ArtaChris/openlst-hw/openlst-hw.kicad_sch

## KiCad design openlst-hw.kicad_sch (2022-05-09)

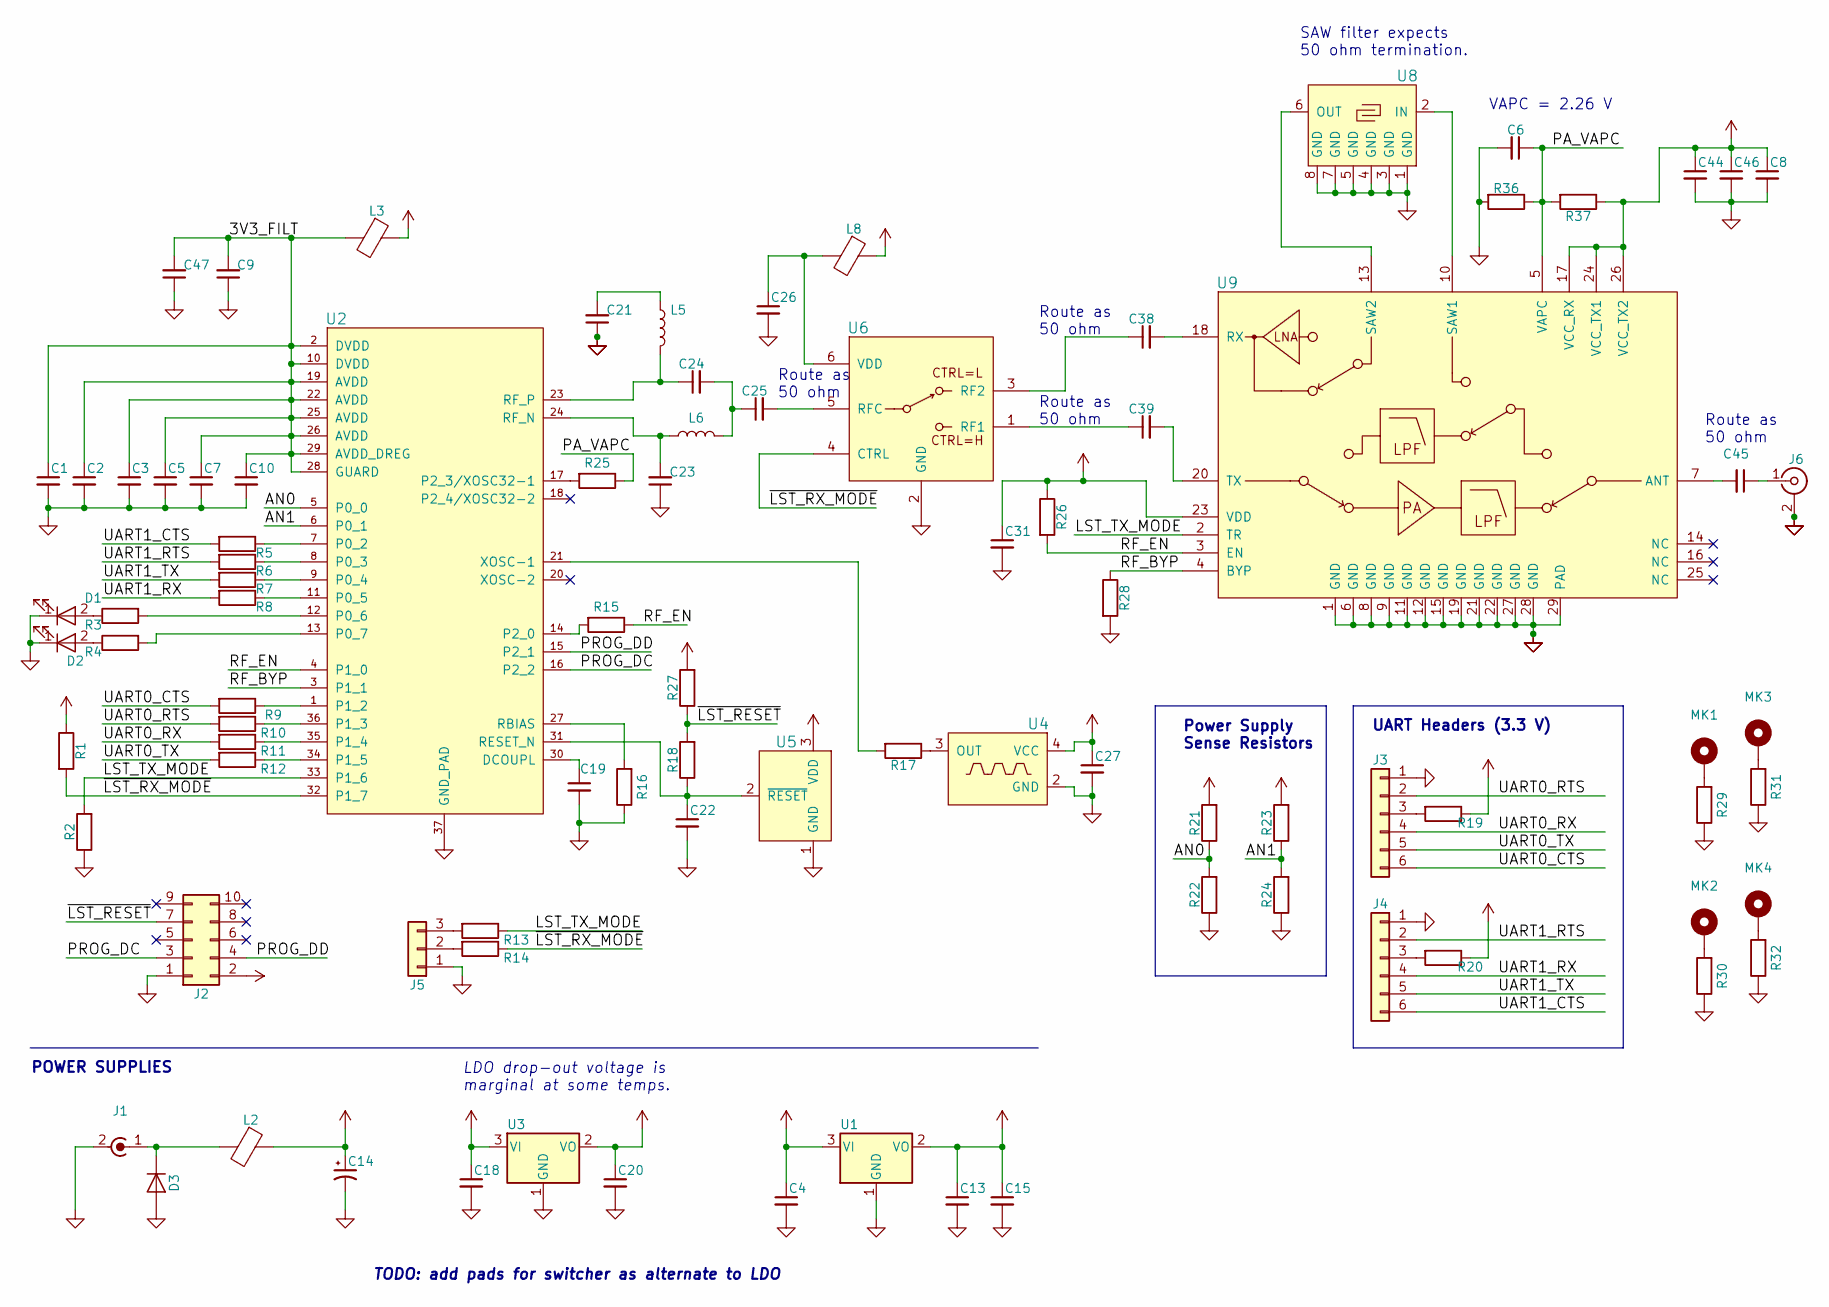
[picture p1: schematic openlst-hw.kicad_sch]

Parts:
C1, C3, C5, C6, C8, C10, C15, C26, C27, C31: ManufPN 0603YC104K4T4A
C2, C7, C21, C25, C38, C39, C45: ManufPN C0402C221J2GACAUTO
C4, C13, C18, C20: ManufPN GRT188C81A106ME13D
C9, C44, C46, C47: ManufPN CL10B105MO8NNWC
C14: ManufPN TPSB107M010R0400
C19, C22: ManufPN GCM188R71E102KA37D
C23, C24: ManufPN GJM1555C1H3R9CB01D
D1: ManufPN 150060VS75000
D2: ManufPN 150060SS75000
D3: ManufPN STPS340U
J1, J5: (no value)
J2: ManufPN FTSH-105-01-L-DV-K-P
J3, J4: ManufPN 61300611121
J6: ManufPN 732511150
L2: ManufPN MI1206L501R-10
L3, L8: ManufPN 74279266
L5, L6: ManufPN LQW15AN27NJ00D
MK1, MK2, MK3, MK4: (no value)
R1, R2, R3, R4, R18, R26, R28: ManufPN RC0603JR-071KL
R5, R6, R7, R8, R9, R10, R11, R12, R13, R14, R17: ManufPN AC0603FR-07100RL
R15, R19, R20, R25, R29, R30, R31, R32: (no value)
R16: ManufPN RMCF0603FT56K0
R21, R23, R27: ManufPN AC0603FR-0733KL
R22, R24: ManufPN RC0603JR-0710KL
R36: ManufPN RMCF0603FT5K60
R37: ManufPN RMCF0603FT3K30
U1: ManufPN LM1117IMP-3.3/NOPB
U2: ManufPN CC1110F32RHHR
U3: ManufPN LT1086CM-3.6#PBF
U4: ManufPN FT5HNBPK27.0-T1
U5: ManufPN TLV803SDBZR
U6: ManufPN 4259-63
U8: ManufPN STA1120A
U9: ManufPN RFFM6403SB

Connections:
3V3_FILT: C1.1, C2.1, C3.1, C5.1, C7.1, C9.2, C10.1, C47.2, L3.2, U2.2 (DVDD), U2.10 (DVDD), U2.19 (AVDD), U2.22 (AVDD), U2.25 (AVDD), U2.26 (AVDD), U2.28 (GUARD), U2.29 (AVDD_DREG)
AN0: R21.1, R22.2, U2.5 (P0_0)
AN1: R23.1, R24.2, U2.6 (P0_1)
LST_TX_MODE: R2.2, R13.1, U2.33 (P1_6), U9.2 (TR)
unnamed: C1.2, C2.2, C3.2, C4.1, C4.2, C5.2, C6.2, C7.2, C8.1, C8.2, C9.1, C10.2, C13.1, C13.2, C14.1, C14.2, C15.1, C15.2, C18.1, C18.2, C19.2, C20.1, C20.2, C21.1, C22.2, C23.1, C26.2, C27.1, C27.2, C31.1, C31.2, C44.1, C44.2, C46.1, C46.2, C47.1, D1.1 (K), D2.1 (K), D3.2 (A), J1.2 (Ext), J2.1, J2.2, J3.1, J4.1, J5.1, J6.2 (Ext), L2.1, L3.1, L8.1, R1.1, R2.1, R16.1, R19.1, R20.1, R21.2, R22.1, R23.2, R24.1, R26.1, R27.2, R28.2, R29.1, R30.1, R31.1, R32.1, R36.2, R37.1, U1.1 (GND), U1.2 (VO), U1.3 (VI), U2.37 (GND_PAD), U3.1 (GND), U3.2 (VO), U3.3 (VI), U4.2 (GND), U4.4 (VCC), U5.1 (GND), U5.3 (VDD), U6.2 (GND), U8.1 (GND), U8.3 (GND), U8.4 (GND), U8.5 (GND), U8.7 (GND), U8.8 (GND), U9.1 (GND), U9.6 (GND), U9.8 (GND), U9.9 (GND), U9.11 (GND), U9.12 (GND), U9.15 (GND), U9.17 (VCC_RX), U9.19 (GND), U9.21 (GND), U9.22 (GND), U9.23 (VDD), U9.24 (VCC_TX1), U9.26 (VCC_TX2), U9.27 (GND), U9.28 (GND), U9.29 (PAD)
unnamed: C19.1, U2.30 (DCOUPL)
unnamed: C21.2, L5.1
unnamed: C22.1, R18.1, U2.31 (RESET_N), U5.2 (~RESET)
unnamed: C23.2, L6.1, U2.24 (RF_N)
unnamed: C24.1, L5.2, U2.23 (RF_P)
unnamed: C24.2, C25.1, L6.2
unnamed: C25.2, U6.5 (RFC)
unnamed: C26.1, L8.2, U6.6 (VDD)
unnamed: C38.1, U6.3 (RF2)
unnamed: C38.2, U9.18 (RX)
unnamed: C39.1, U6.1 (RF1)
unnamed: C39.2, U9.20 (TX)
unnamed: C45.1, J6.1 (In)
unnamed: C45.2, U9.7 (ANT)
unnamed: D1.2 (A), R3.1
unnamed: D2.2 (A), R4.1
unnamed: D3.1 (K), J1.1 (In), L2.2
unnamed: J3.3, R19.2
unnamed: J4.3, R20.2
unnamed: J5.2, R14.2
unnamed: J5.3, R13.2
unnamed: MK1.1, R29.2
unnamed: MK2.1, R30.2
unnamed: MK3.1, R31.2
unnamed: MK4.1, R32.2
unnamed: R3.2, U2.12 (P0_6)
unnamed: R4.2, U2.13 (P0_7)
unnamed: R5.1, U2.7 (P0_2)
unnamed: R6.1, U2.8 (P0_3)
unnamed: R7.1, U2.9 (P0_4)
unnamed: R8.1, U2.11 (P0_5)
unnamed: R9.1, U2.1 (P1_2)
unnamed: R10.1, U2.36 (P1_3)
unnamed: R11.1, U2.35 (P1_4)
unnamed: R12.1, U2.34 (P1_5)
unnamed: R15.2, U2.14 (P2_0)
unnamed: R16.2, U2.27 (RBIAS)
unnamed: R17.1, U4.3 (OUT)
unnamed: R17.2, U2.21 (XOSC-1)
unnamed: R25.2, U2.17 (P2_3/XOSC32-1)
unnamed: U8.2 (IN), U9.10 (SAW1)
unnamed: U8.6 (OUT), U9.13 (SAW2)
PA_VAPC: C6.1, R25.1, R36.1, R37.2, U9.5 (VAPC)
PROG_DC: J2.3, U2.16 (P2_2)
PROG_DD: J2.4, U2.15 (P2_1)
RF_BYP: R28.1, U2.3 (P1_1), U9.4 (BYP)
RF_EN: R15.1, R26.2, U2.4 (P1_0), U9.3 (EN)
UART0_CTS: J3.6, R9.2
UART0_RTS: J3.2, R10.2
UART0_RX: J3.4, R11.2
UART0_TX: J3.5, R12.2
UART1_CTS: J4.6, R5.2
UART1_RTS: J4.2, R6.2
UART1_RX: J4.4, R8.2
UART1_TX: J4.5, R7.2
~LST_RESET: J2.7, R18.2, R27.1
~LST_RX_MODE: R1.2, R14.1, U2.32 (P1_7), U6.4 (CTRL)

Notes on the sheet:
SAW filter expects 50 ohm termination.
Route as 50 ohm
TODO: add pads for switcher as alternate to LDO
POWER SUPPLIES
UART Headers (3.3 V)
Power Supply Sense Resistors
LDO drop-out voltage is marginal at some temps.
VAPC = 2.26 V
