ArtaChris/openlst-hw/rescue-backup/openlst-hw-2022-05-08-21-41-04.sch

## KiCad design rescue-backup/openlst-hw-2022-05-08-21-41-04.sch (2022-05-09)

Schematic: openlst-hw-2022-05-08-21-41-04.sch

Parts:
C1, C3, C5, C6, C8, C10, C15, C26, C27, C31: 0.1u; C_0603_1608Metric; ManufPN 0603YC104K4T4A
C2, C7, C21, C25, C38, C39, C45: 220p; C_0402_1005Metric; ManufPN C0402C221J2GACAUTO
C4, C13, C18, C20: 10u; C_0603_1608Metric; ManufPN GRT188C81A106ME13D
C9, C44, C46, C47: 1u; C_0603_1608Metric; ManufPN CL10B105MO8NNWC
C14: 100u; CP_EIA-3528-15_AVX-H; ManufPN TPSB107M010R0400
C19, C22: 1n; C_0603_1608Metric; ManufPN GCM188R71E102KA37D
C23, C24: 3.9p; C_0402_1005Metric; ManufPN GJM1555C1H3R9CB01D
D1: LED; LED_0603_1608Metric; ManufPN 150060VS75000
D2: LED; LED_0603_1608Metric; ManufPN 150060SS75000
D3: STPS340U; D_SMB; ManufPN STPS340U
J1: 5VDC; PinHeader_1x02_P2.54mm_Vertical
J2: CC Prog/Debug; PinHeader_2x05_P1.27mm_Vertical_SMD; ManufPN FTSH-105-01-L-DV-K-P
J3: UART0; PinHeader_1x06_P2.54mm_Vertical; ManufPN 61300611121
J4: UART1; PinHeader_1x06_P2.54mm_Vertical; ManufPN 61300611121
J5: Control Outputs; PinHeader_1x03_P2.54mm_Vertical
J6: ANT; SMA_Molex_73251-1153_EdgeMount_Horizontal; ManufPN 732511150
L2: Z=500 @ 100M; L_1206_3216Metric; ManufPN MI1206L501R-10
L3, L8: Z=1k @ 100M; L_0603_1608Metric; ManufPN 74279266
L5, L6: 27n; L_0402_1005Metric; ManufPN LQW15AN27NJ00D
MK1, MK2, MK3, MK4: M3_Hole; MountingHole_3.2mm_M3_Pad_Via
R1, R2, R3, R4, R18, R26, R28: 1K; R_0603_1608Metric; ManufPN RC0603JR-071KL
R5, R6, R7, R8, R9, R10, R11, R12, R13, R14, R17: 100; R_0603_1608Metric; ManufPN AC0603FR-07100RL
R15, R19, R20, R25, R29, R30, R31, R32: DNI; R_0603_1608Metric
R16: 56K; R_0603_1608Metric; ManufPN RMCF0603FT56K0
R21, R23, R27: 33K; R_0603_1608Metric; ManufPN AC0603FR-0733KL
R22, R24: 10K; R_0603_1608Metric; ManufPN RC0603JR-0710KL
R36: 5K6; R_0603_1608Metric; ManufPN RMCF0603FT5K60
R37: 3K3; R_0603_1608Metric; ManufPN RMCF0603FT3K30
U1: LM1117-3.3; SOT-223-3_TabPin2; ManufPN LM1117IMP-3.3/NOPB
U2: CC1110; TI_CC_QFN36; ManufPN CC1110F32RHHR
U3: LT1086-3.6; TO-263-3_TabPin2; ManufPN LT1086CM-3.6#PBF
U4: FOX924 27MHz; Oscillator_SMD_Fordahl_DFAS15-4Pin_5.0x3.2mm; ManufPN FT5HNBPK27.0-T1
U5: TLV803S; SOT-23; ManufPN TLV803SDBZR
U6: PE4259; SOT-363_SC-70-6; ManufPN 4259-63
U8: STA1120A; SAW-8_3.8mm; ManufPN STA1120A
U9: RFFM6403; Qorvo_LGA_28_ThermalVias; ManufPN RFFM6403SB

Notes on the sheet:
POWER SUPPLIES
VAPC = 2.26 V
TODO: add pads for switcher as alternate to LDO
UART Headers (3.3 V)
Power Supply Sense Resistors
LDO drop-out voltage is marginal at some temps.
SAW filter expects 50 ohm termination.
Route as 50 ohm
