ArtaChris/openlst-hw/(notices)

Notices in the files:
rescue-backup/openlst-hw-2022-05-08-21-41-04.sch:
This work is licensed under a Creative Commons Attribution-ShareAlike 4.0 International
Copyright 2018 Planet Labs Inc
